zh979/FPGAqiansai/board/ps_pins.txt

开发板PS IO引脚列表
信号名 | 管脚 | 端口说明
2个PS功能按键
ps_key[0] | MIO12 | PS按键KEY0
ps_key[1] | MIO11 | PS按键KEY1
3个PS_LED灯
ps_led[0]（底板） | MIO7 | PS_LED0
ps_led[1]（底板） | MIO8 | PS_LED1
ps_led（核心板） | MIO0 | PS_LED
QSPI FLASH
QSPI_CS# | MIO1 | QSPI FLASH的片选，低电平有效
QSPI_SCK | MIO6 | QSPI FLASH的时钟
QSPI_D0 | MIO2 | QSPI FLASH的数据位0
QSPI_D1 | MIO3 | QSPI FLASH的数据位1
QSPI_D2 | MIO4 | QSPI FLASH的数据位2
QSPI_D3 | MIO5 | QSPI FLASH的数据位3
PS UART
PS_UART_RXD | MIO14 | PS UART的接收
PS_UART_TXD | MIO15 | PS UART的发送
PS 以太网
ETH_TXCK | MIO16 | PS以太网RGMII接口的TX_CLK
ETH_TXD0 | MIO17 | PS以太网RGMII接口的TX_D0
ETH_TXD1 | MIO18 | PS以太网RGMII接口的TX_D1
ETH_TXD2 | MIO19 | PS以太网RGMII接口的TX_D2
ETH_TXD3 | MIO20 | PS以太网RGMII接口的TX_D3
ETH_TXCTL | MIO21 | PS以太网RGMII接口的TX_CTL
ETH_RXCK | MIO22 | PS以太网RGMII接口的RX_CLK
ETH_RXD0 | MIO23 | PS以太网RGMII接口的RX_D0
ETH_RXD1 | MIO24 | PS以太网RGMII接口的RX_D1
ETH_RXD2 | MIO25 | PS以太网RGMII接口的RX_D2
ETH_RXD3 | MIO26 | PS以太网RGMII接口的RX_D3
ETH_RXCTL | MIO27 | PS以太网RGMII接口的RX_CTL
ETH_MDC | MIO52 | PS以太网MDIO接口的时钟
ETH_MDIO | MIO53 | PS以太网MDIO接口的数据
PS USB接口
OTG_DIR | MIO29 | USB总线方向控制
OTG_STP | MIO30 | 数据传输的结束信号
OTG_NXT | MIO31 | 当前数据接收完成指示信号
OTG_CLK | MIO36 | PHY的时钟输出
OTG_DATA7 | MIO39 | 双向数据总线位7
OTG_DATA6 | MIO38 | 双向数据总线位6
OTG_DATA5 | MIO37 | 双向数据总线位5
OTG_DATA4 | MIO28 | 双向数据总线位4
OTG_DATA3 | MIO35 | 双向数据总线位3
OTG_DATA2 | MIO34 | 双向数据总线位2
OTG_DATA1 | MIO33 | 双向数据总线位1
OTG_DATA0 | MIO32 | 双向数据总线位0
SD卡
SD_CLK | MIO40 | SD卡的时钟信号
SD_CMD | MIO41 | SD卡的命令信号
SD_D0 | MIO42 | SD卡的DATA0
SD_D1 | MIO43 | SD卡的DATA1
SD_D2 | MIO44 | SD卡的DATA2
SD_D3 | MIO45 | SD卡的DATA3
eMMC存储器
eMMC_CCLK | MIO48 | eMMC的时钟信号
eMMC_CMD | MIO47 | eMMC的命令信号
eMMC_D0 | MIO46 | eMMC的DATA0
eMMC_D1 | MIO49 | eMMC的DATA1
eMMC_D2 | MIO50 | eMMC的DATA2
eMMC_D3 | MIO51 | eMMC的DATA3
