zh979/FPGAqiansai/(commit log)

2026-11-03 智能激光除草系统: ZYNQ-7020 实时杂草识别与精准照射
    单片 ZYNQ-7020 完成采集->CNN推理->跟踪->云台瞄准->激光照射闭环。
    PL 侧 HLS 综合的 128 路并行卷积加速器, PS 侧裸机运行预处理、后处理、
    卡尔曼跟踪与激光安全状态机, STM32 只做 UART->CAN 转换与物理兜底。
    板上实测: 整网推理 429 ms/帧, 单层加速比 106x, 瞄准中位误差 5.9 mm,
    事件驱动省去 33% 推理。DSP 220/220 用满, WNS +0.189 ns @ 120 MHz。
    工具链 Vivado/Vitis 2019.2, 器件 xc7z020clg400-2。
    build/hw/ 附预构建 XSA 与 bitstream, 无需综合即可上板。
2026-11-03 补充大模型协作记录与报告 5.3 节
    llm_collab_log.md 增加四条工程排查的自我纠错轨迹:
    - 定点失配: 五个假设逐一在 PC 上仿真证伪, 根因是 HLS 累加器
    逐项 round+saturate, 结论是 bit-exact 对异构实现不是合理标准
    - 对照组选取: 复刻硬件截断会把 ARM 从 874ms 拖到 1340ms,
    加速比虚涨到 162x, 已撤回并保留 106x
    - 重复照射: 先误判为判重半径不足, 真因是 mark_done 时机
    - 修复引入新故障: 静态打靶失效的两处成因
    报告 5.3 节同步增加对照组选取一条, 并指向完整轨迹。
    顺带删除误入库的 Word 锁文件并加入 .gitignore。
2026-11-03 修正开发板描述: 未使用自制底板
